yacremann/electron_event_generator/Board/Electron_generator/3D_files/conn_3.81mm.step

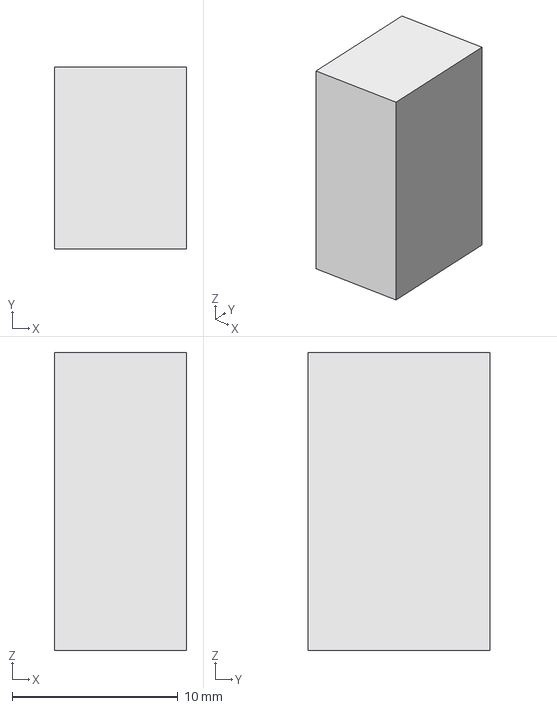
[picture p1: CAD file, 2022-10-03]
Board/Electron_generator/3D_files/conn_3.81mm.step
8.00 x 11.0 x 18.0 mm
