yacremann/electron_event_generator/Board/Electron_generator/Electron_generator.step

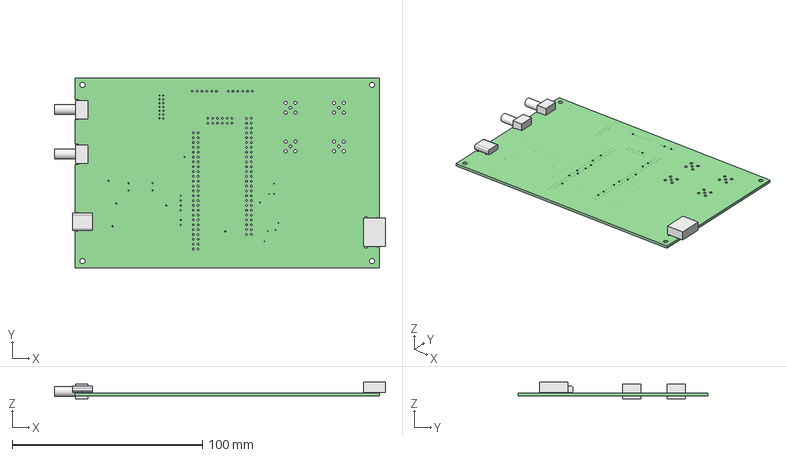
[picture p2: CAD file, 2022-10-03]
Board/Electron_generator/Electron_generator.step
173.8 x 100.0 x 8.90 mm
Electron_generator PCB
