yacremann/electron_event_generator/Board/Electron_generator/3D_files/HDMI_90.step

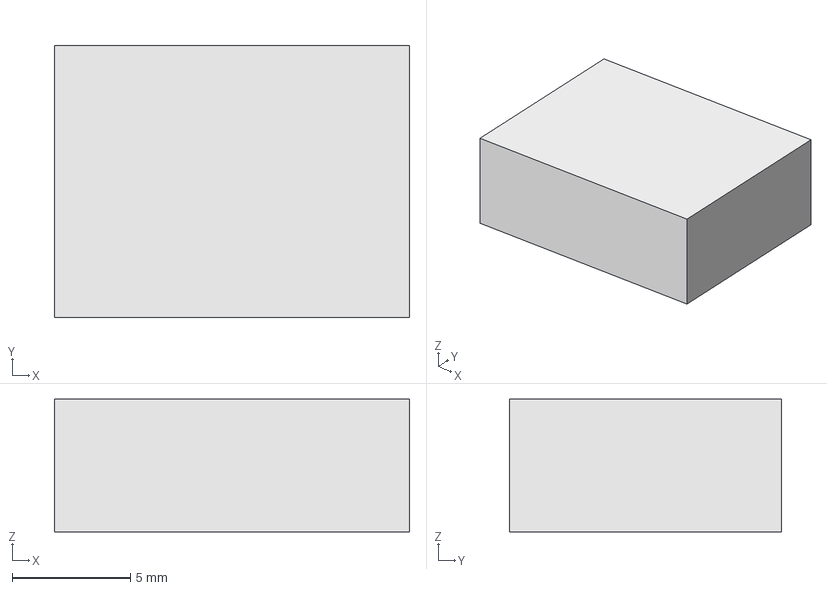
[picture p3: CAD file, 2022-10-03]
Board/Electron_generator/3D_files/HDMI_90.step
15.0 x 11.5 x 5.60 mm
