yacremann/electron_event_generator/Board/Electron_generator/3D_files/USB_C.step

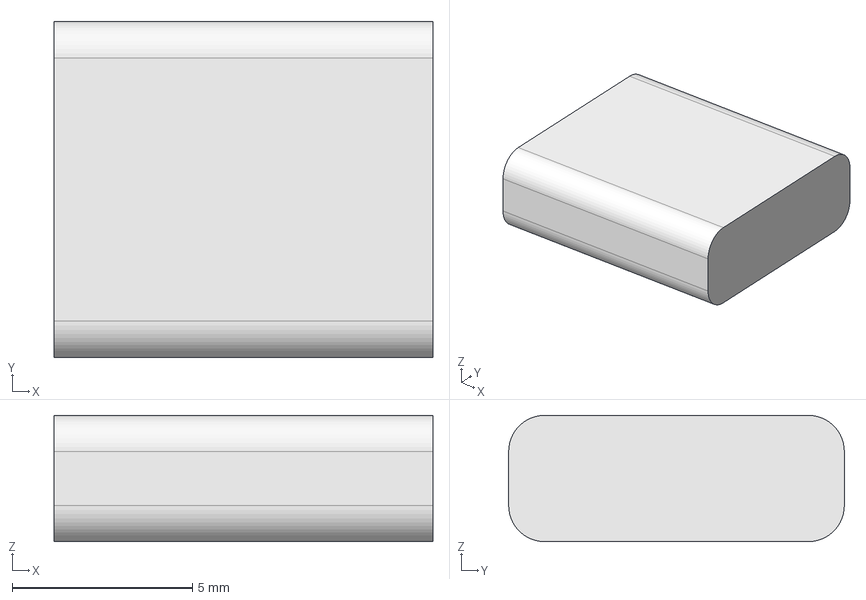
[picture p4: CAD file, 2022-10-03]
Board/Electron_generator/3D_files/USB_C.step
10.5 x 9.30 x 3.50 mm
