yacremann/electron_event_generator/Board/Electron_generator/3D_files/conn_sma.step

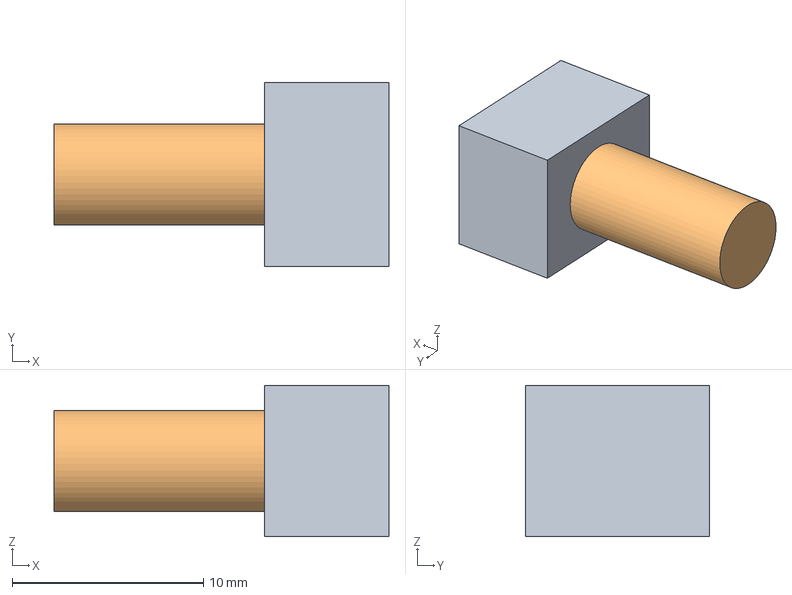
[picture p5: CAD file, 2022-10-03]
Board/Electron_generator/3D_files/conn_sma.step
17.5 x 9.60 x 7.90 mm
