yacremann/electron_event_generator/Board/Electron_generator/3D_files/RJ45.step

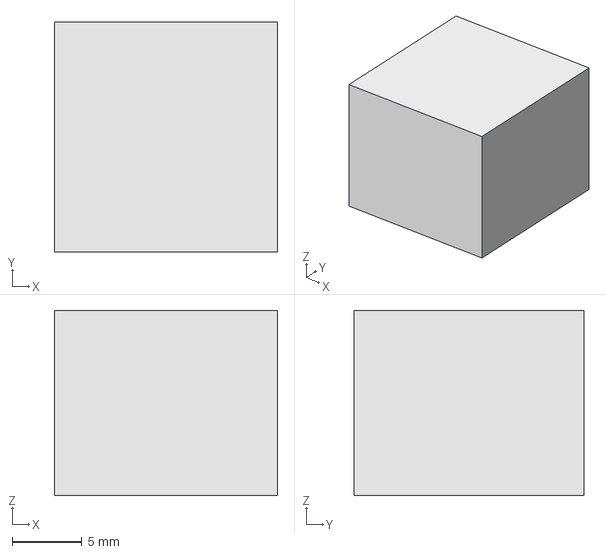
[picture p6: CAD file, 2022-10-03]
Board/Electron_generator/3D_files/RJ45.step
16.0 x 16.5 x 13.3 mm
