yacremann/electron_event_generator/(list of files, cad)

Other CAD files:
Board/Electron_generator/3D_files/HDMI_90.FCStd
Board/Electron_generator/3D_files/RJ45.FCStd
Board/Electron_generator/3D_files/USB_C.FCStd
Board/Electron_generator/3D_files/conn_3.81mm.FCStd
Board/Electron_generator/3D_files/conn_sma.FCStd
