yacremann/electron_event_generator/Board/Electron_generator/Schematic.pdf

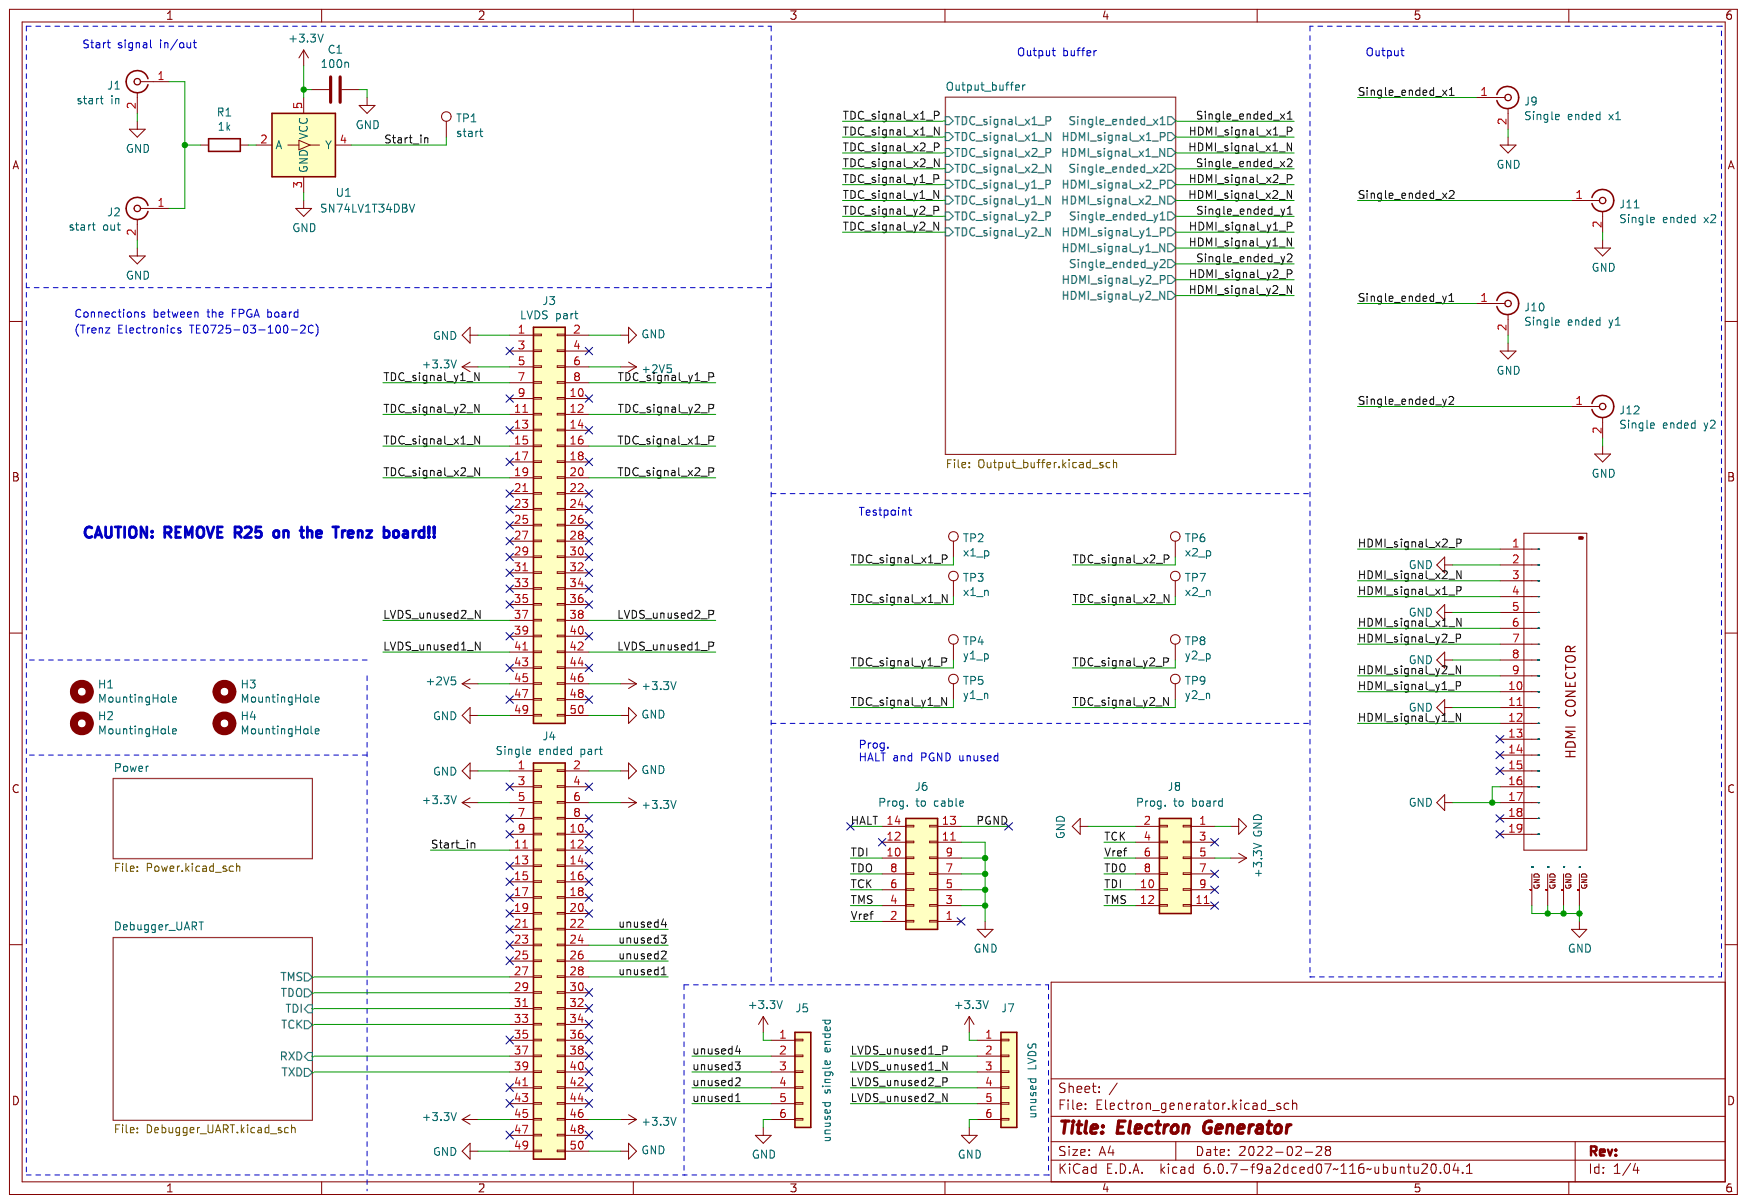
[picture p7: page 1]

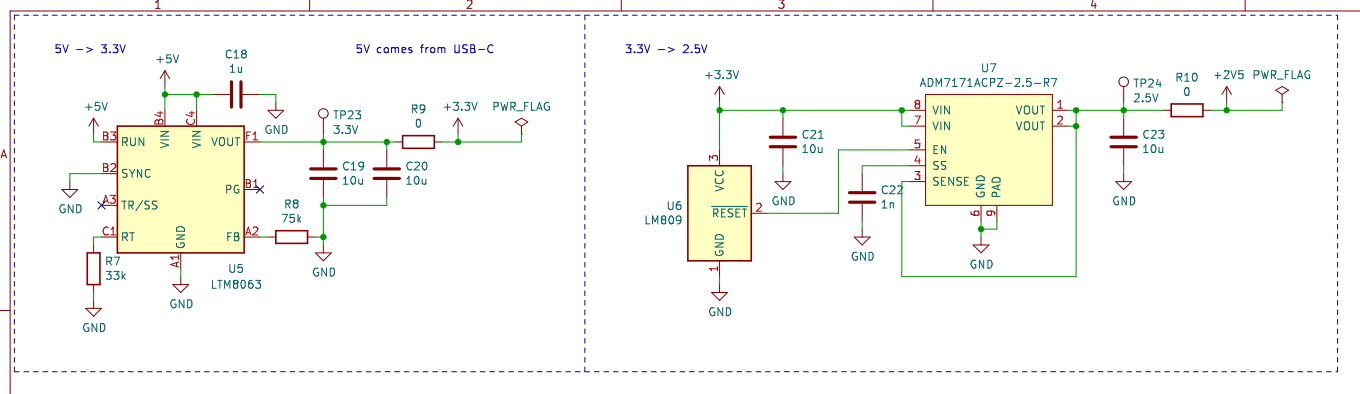
[picture p8: page 2]

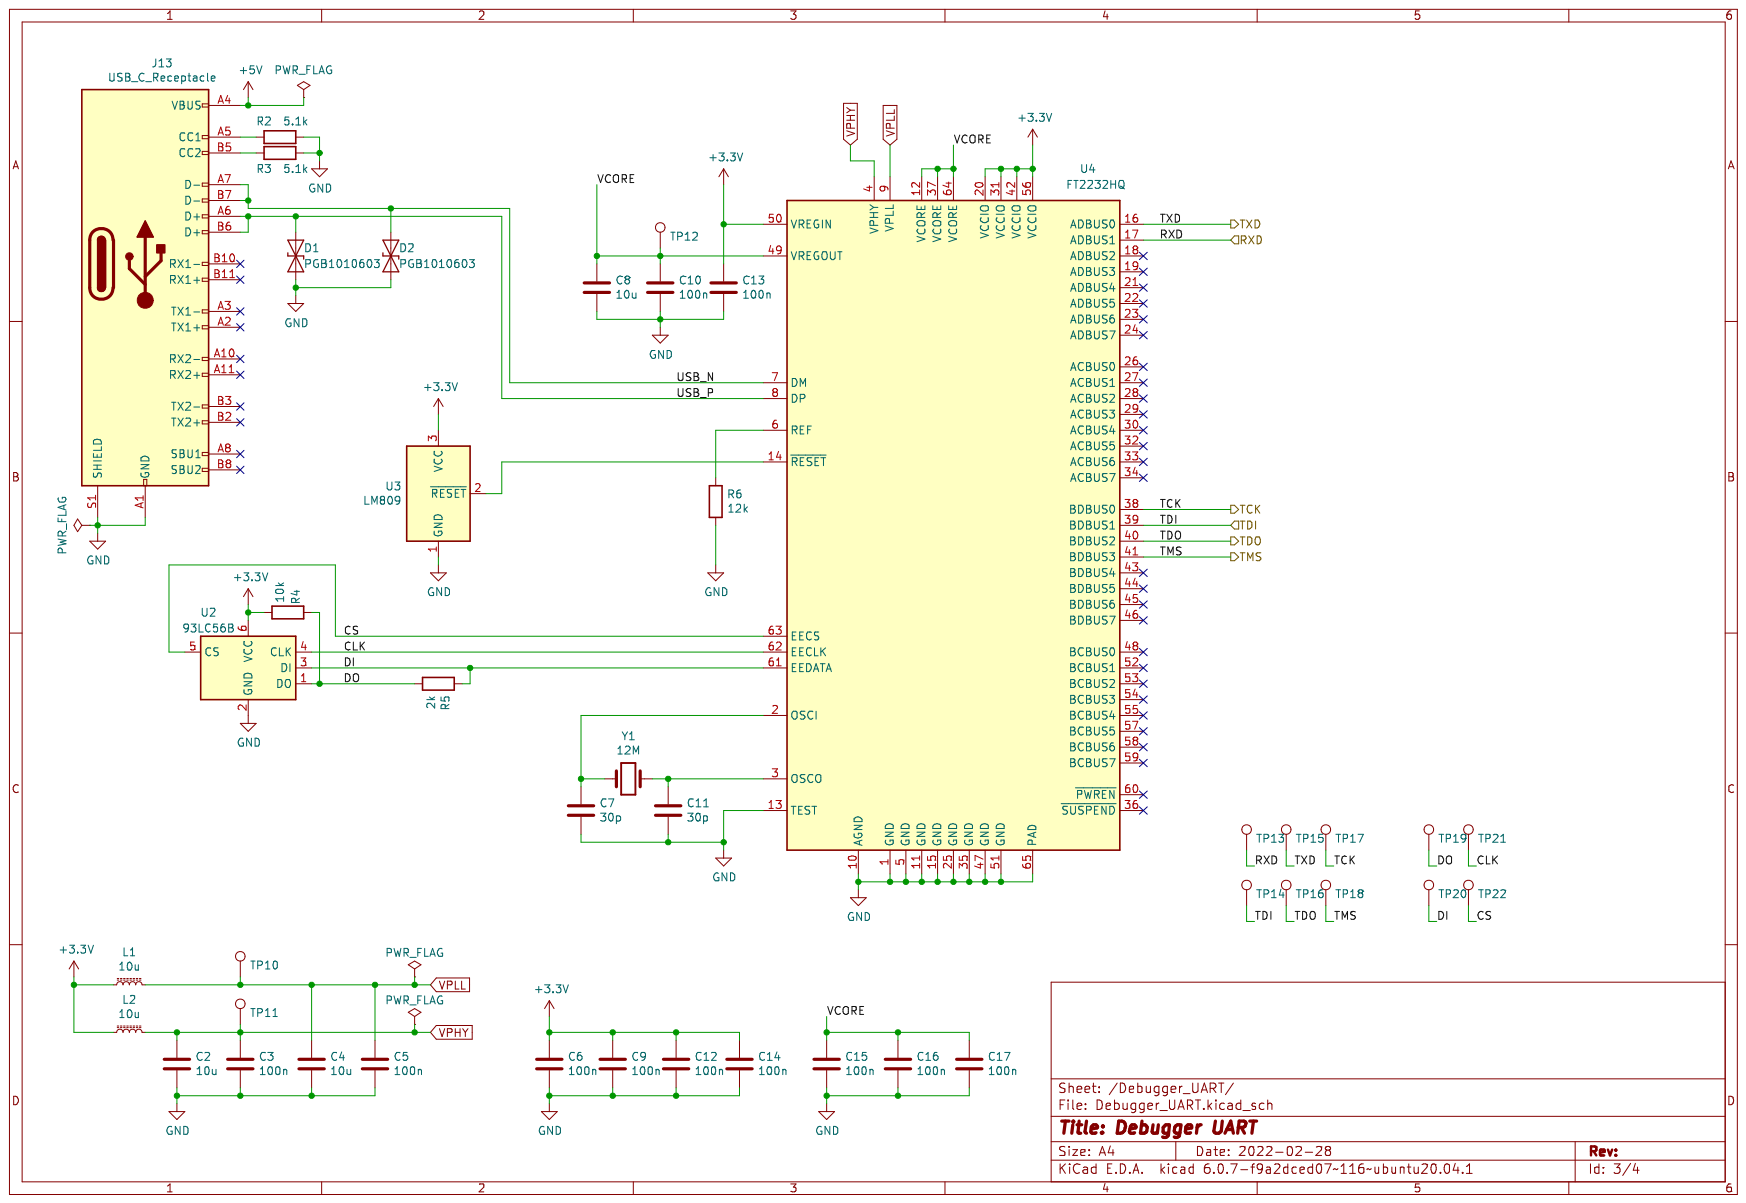
[picture p9: page 3]

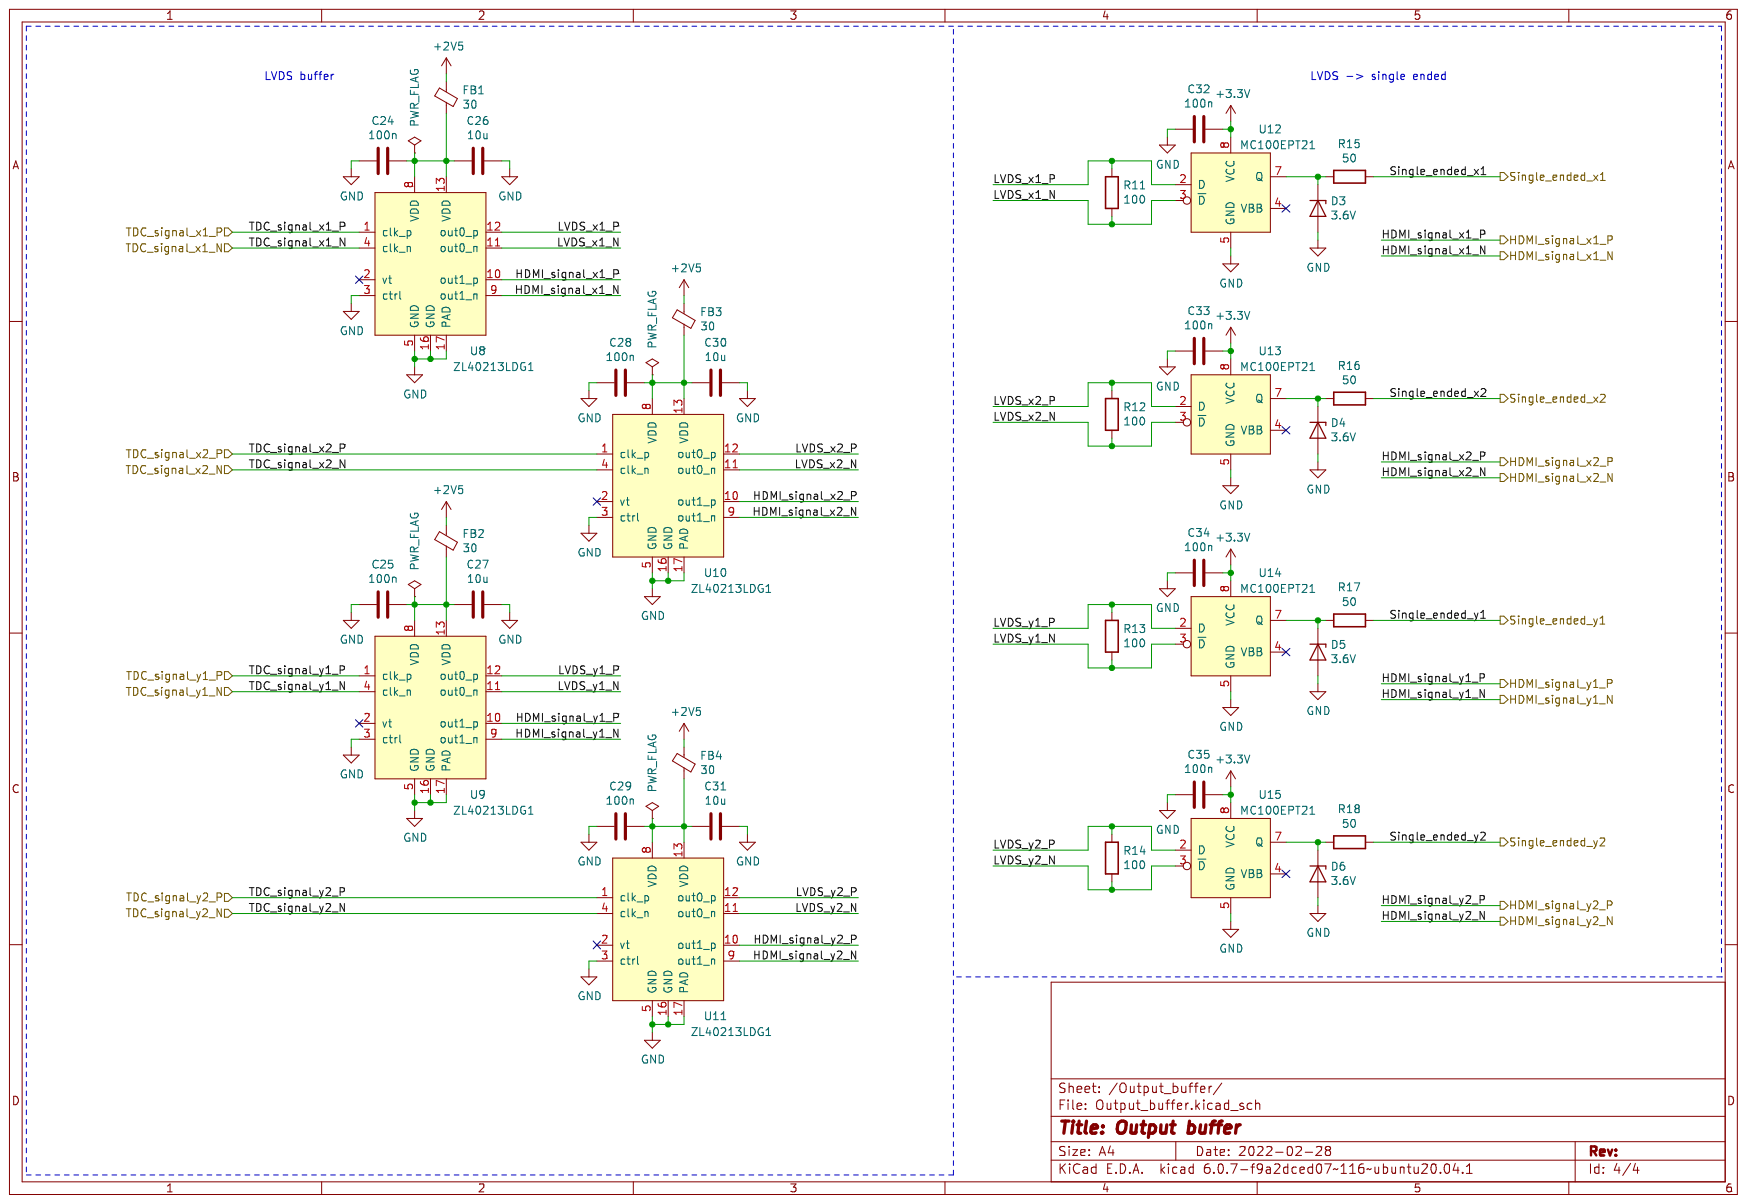
[picture p10: page 4]
