yacremann/electron_event_generator/Board/Electron_generator/Debugger_UART.kicad_sch

## KiCad design Board/Electron_generator/Debugger_UART.kicad_sch (2022-10-03)

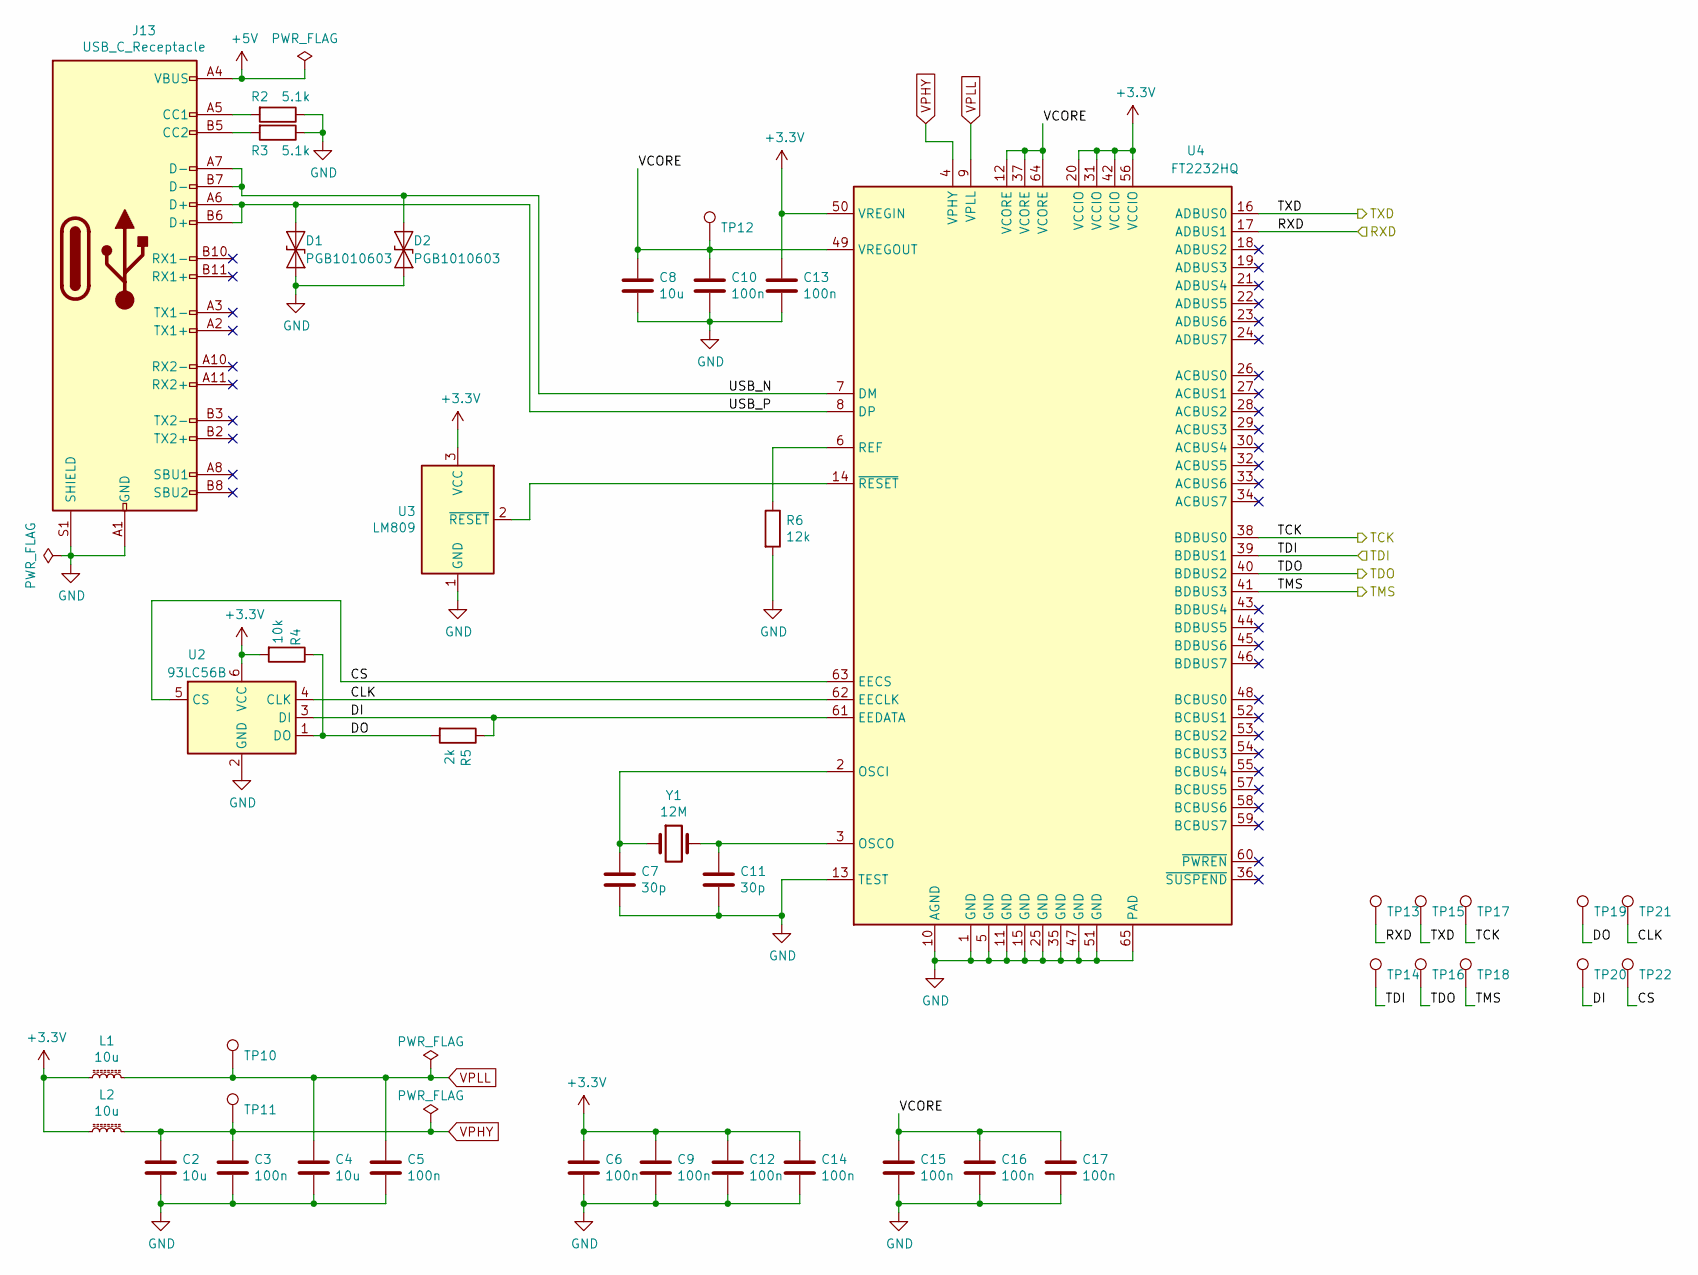
[picture p11: schematic Debugger_UART.kicad_sch]

Parts:
C2, C4, C8: 10u; C_0603_1608Metric
C3, C5, C6, C9, C10, C12, C13, C14, C15, C16, C17: 100n; C_0603_1608Metric
C7, C11: 30p; C_0603_1608Metric
D1, D2: PGB1010603; D_0603_1608Metric
J13: USB_C_Receptacle; USB_C_Receptacle_Amphenol_12401610E4-2A_CircularHoles
L1, L2: 10u; L_1008_2520Metric
R2, R3: 5.1k; R_0603_1608Metric
R4: 10k; R_0603_1608Metric
R5: 2k; R_0603_1608Metric
R6: 12k; R_0603_1608Metric
TP10, TP11, TP12, TP13, TP14, TP15, TP16, TP17, TP18, TP19, TP20, TP21, TP22: TestPoint; TestPoint_THTPad_D1.5mm_Drill0.7mm
U2: 93LC56B; SOT-23-6
U3: LM809; SOT-23
U4: FT2232HQ; QFN-64-1EP_9x9mm_P0.5mm_EP4.35x4.35mm
Y1: 12M; Crystal_SMD_5032-2Pin_5.0x3.2mm

Connections:
+3.3V: C6.1, C9.1, C12.1, C13.1, C14.1, L1.1, L2.1, R4.2, U2.6 (VCC), U3.3 (VCC), U4.20 (VCCIO), U4.31 (VCCIO), U4.42 (VCCIO), U4.50 (VREGIN), U4.56 (VCCIO)
+5V: J13.A4 (VBUS), J13.A9 (VBUS), J13.B4 (VBUS), J13.B9 (VBUS)
CLK: TP21.1, U2.4 (CLK), U4.62 (EECLK)
CS: TP22.1, U2.5 (CS), U4.63 (EECS)
DI: R5.1, TP20.1, U2.3 (DI), U4.61 (EEDATA)
DO: R4.1, R5.2, TP19.1, U2.1 (DO)
GND: C2.2, C3.2, C4.2, C5.2, C6.2, C7.2, C8.2, C9.2, C10.2, C11.2, C12.2, C13.2, C14.2, C15.2, C16.2, C17.2, D1.2 (A2), D2.2 (A2), J13.A1 (GND), J13.A12 (GND), J13.B1 (GND), J13.B12 (GND), J13.S1 (SHIELD), R2.1, R3.1, R6.2, U2.2 (GND), U3.1 (GND), U4.1 (GND), U4.5 (GND), U4.10 (AGND), U4.11 (GND), U4.13 (TEST), U4.15 (GND), U4.25 (GND), U4.35 (GND), U4.47 (GND), U4.51 (GND), U4.65 (PAD)
unnamed: C7.1, U4.2 (OSCI), Y1.1
unnamed: C11.1, U4.3 (OSCO), Y1.2
unnamed: J13.A5 (CC1), R2.2
unnamed: J13.B5 (CC2), R3.2
unnamed: R6.1, U4.6 (REF)
unnamed: U3.2 (~RESET), U4.14 (~RESET)
RXD: TP13.1, U4.17 (ADBUS1)
TCK: TP17.1, U4.38 (BDBUS0)
TDI: TP14.1, U4.39 (BDBUS1)
TDO: TP16.1, U4.40 (BDBUS2)
TMS: TP18.1, U4.41 (BDBUS3)
TXD: TP15.1, U4.16 (ADBUS0)
USB_N: D2.1 (A1), J13.A7 (D-), J13.B7 (D-), U4.7 (DM)
USB_P: D1.1 (A1), J13.A6 (D+), J13.B6 (D+), U4.8 (DP)
VCORE: C8.1, C10.1, C15.1, C16.1, C17.1, TP12.1, U4.12 (VCORE), U4.37 (VCORE), U4.49 (VREGOUT), U4.64 (VCORE)
VPHY: C2.1, C3.1, L2.2, TP11.1, U4.4 (VPHY)
VPLL: C4.1, C5.1, L1.2, TP10.1, U4.9 (VPLL)
