yacremann/electron_event_generator/Board/Electron_generator/Electron_generator.kicad_sch

## KiCad design Board/Electron_generator/Electron_generator.kicad_sch (2022-10-03)

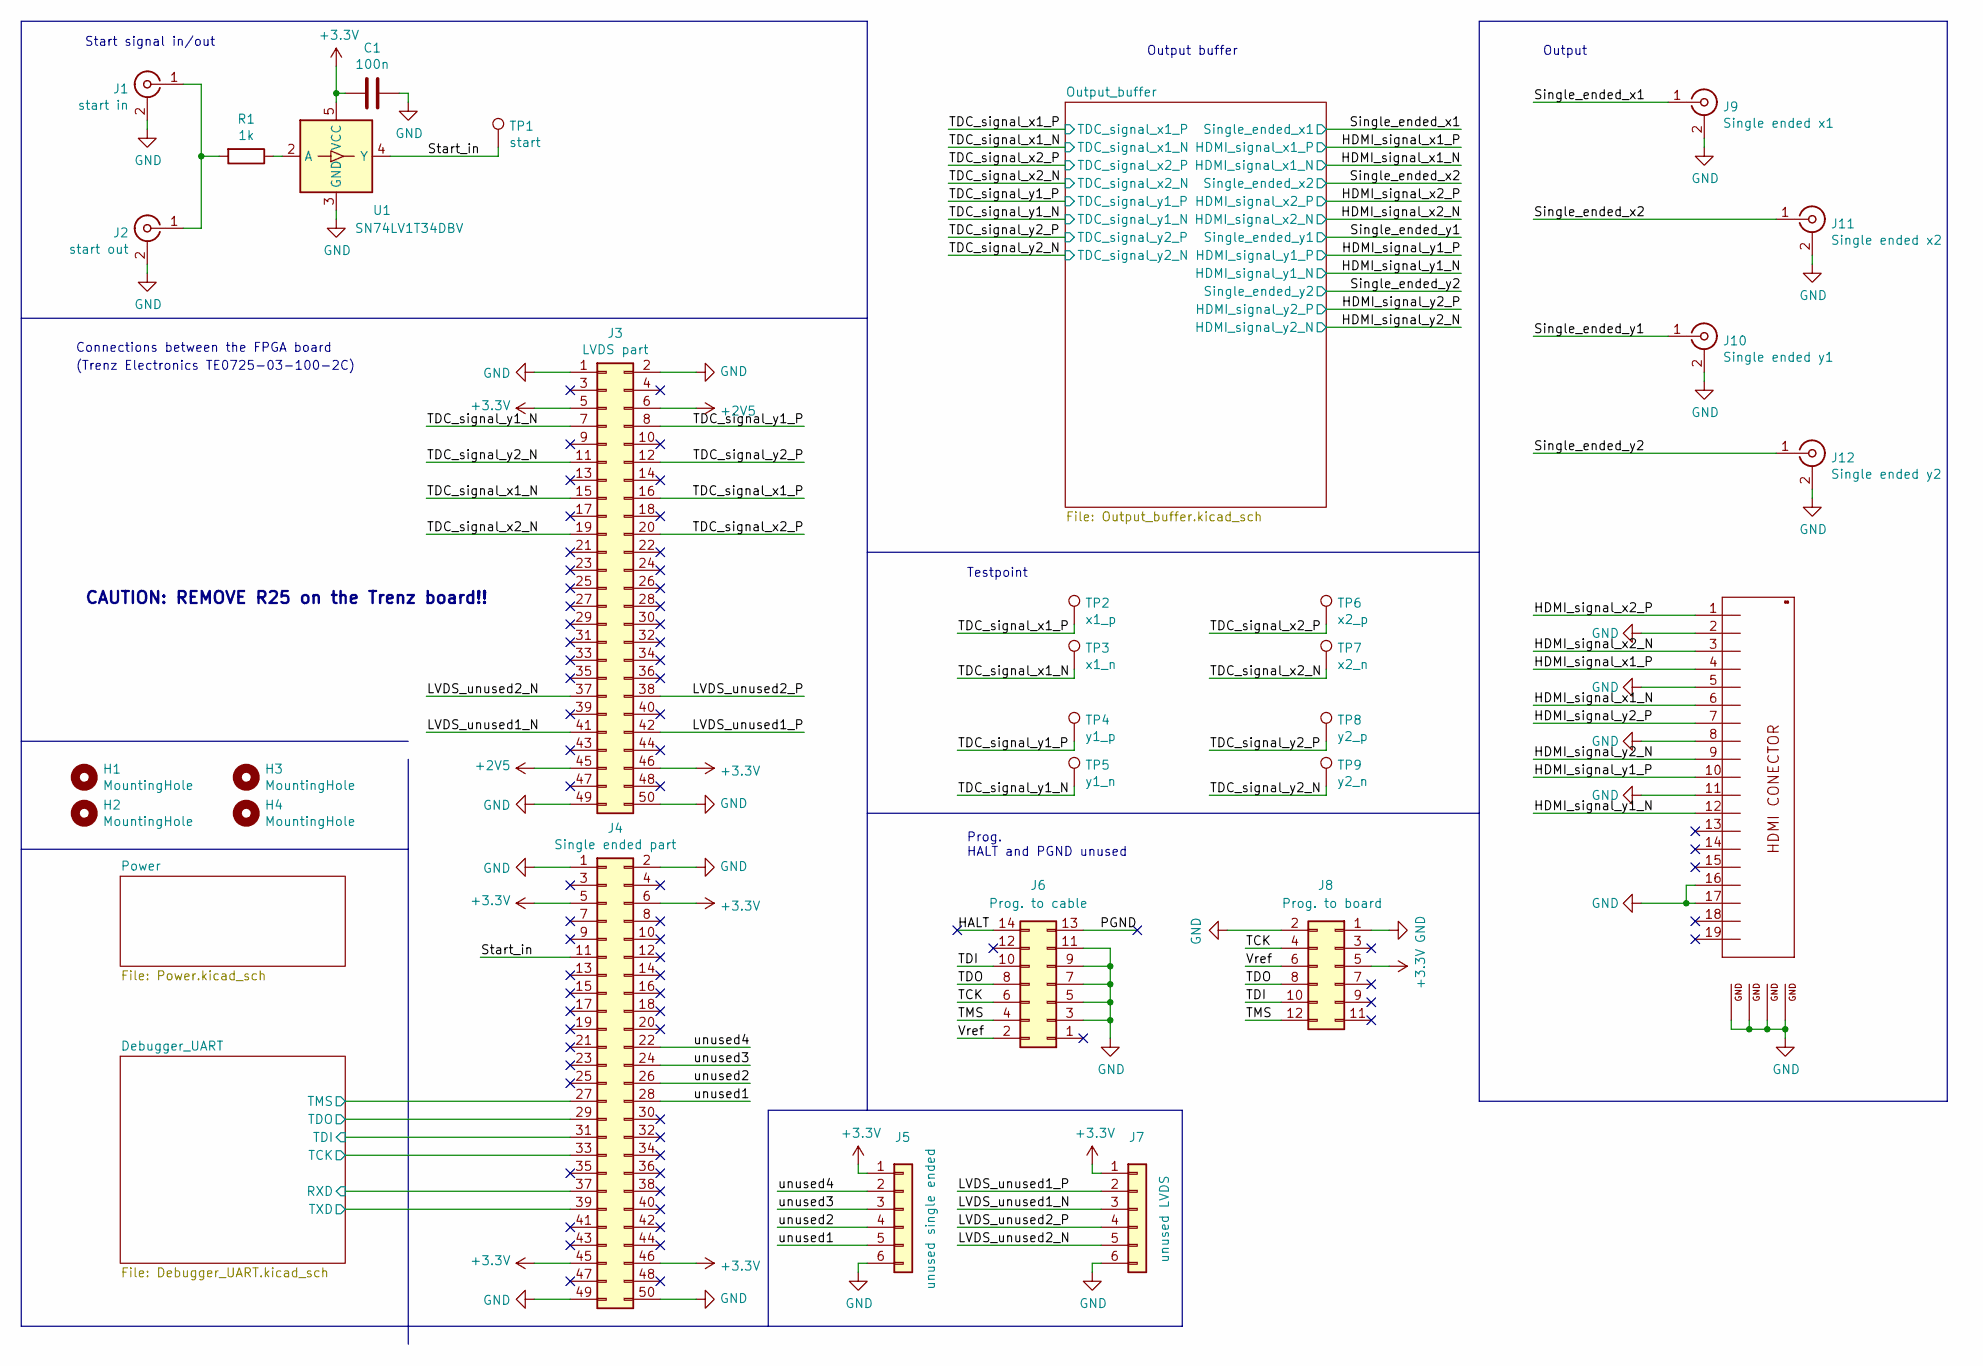
[picture p12: schematic Electron_generator.kicad_sch]

Parts:
C1: 100n; C_0603_1608Metric
H1, H2, H3, H4: MountingHole; MountingHole_2.7mm_M2.5
J1: start in; SMA_Amphenol_132289_EdgeMount
J2: start out; SMA_Amphenol_132289_EdgeMount
J3: LVDS part; PinSocket_2x25_P2.54mm_Vertical
J4: Single ended part; PinSocket_2x25_P2.54mm_Vertical
J5: unused single ended; PinSocket_1x06_P2.54mm_Vertical
J6: Prog. to cable; JST_PHD_B14B-PHDSS_2x07_P2.00mm_Vertical
J7: unused LVDS; PinSocket_1x06_P2.54mm_Vertical
J8: Prog. to board; PinSocket_2x06_P2.54mm_Vertical
J9: Single ended x1; SMA_Amphenol_901-144_Vertical
J10: Single ended y1; SMA_Amphenol_901-144_Vertical
J11: Single ended x2; SMA_Amphenol_901-144_Vertical
J12: Single ended y2; SMA_Amphenol_901-144_Vertical
R1: 1k; R_0603_1608Metric
ST1: HDMI_CONNECTOR90°; HDMI_90_SMD
TP1: start; TestPoint_THTPad_D1.5mm_Drill0.7mm
TP2: x1_p; TestPoint_THTPad_D1.0mm_Drill0.5mm
TP3: x1_n; TestPoint_THTPad_D1.0mm_Drill0.5mm
TP4: y1_p; TestPoint_THTPad_D1.0mm_Drill0.5mm
TP5: y1_n; TestPoint_THTPad_D1.0mm_Drill0.5mm
TP6: x2_p; TestPoint_THTPad_D1.0mm_Drill0.5mm
TP7: x2_n; TestPoint_THTPad_D1.0mm_Drill0.5mm
TP8: y2_p; TestPoint_THTPad_D1.0mm_Drill0.5mm
TP9: y2_n; TestPoint_THTPad_D1.0mm_Drill0.5mm
U1: SN74LV1T34DBV; SOT-23-5

Connections:
+2V5: J3.6, J3.45
+3.3V: C1.2, J3.5, J3.46, J4.5, J4.6, J4.45, J4.46, J5.1, J7.1, J8.5, U1.5 (VCC)
GND: C1.1, J1.2 (Ext), J2.2 (Ext), J3.1, J3.2, J3.49, J3.50, J4.1, J4.2, J4.49, J4.50, J5.6, J6.3, J6.5, J6.7, J6.9, J6.11, J7.6, J8.1, J8.2, J9.2 (Ext), J10.2 (Ext), J11.2 (Ext), J12.2 (Ext), ST1.2, ST1.5, ST1.8, ST1.11, ST1.16, ST1.17, ST1.P$1 (GND), ST1.P$2 (GND), ST1.P$3 (GND), ST1.P$4 (GND), U1.3 (GND)
HALT: J6.14
HDMI_signal_x1_N: ST1.6
HDMI_signal_x1_P: ST1.4
HDMI_signal_x2_N: ST1.3
HDMI_signal_x2_P: ST1.1
HDMI_signal_y1_N: ST1.12
HDMI_signal_y1_P: ST1.10
HDMI_signal_y2_N: ST1.9
HDMI_signal_y2_P: ST1.7
LVDS_unused1_N: J3.41, J7.3
LVDS_unused1_P: J3.42, J7.2
LVDS_unused2_N: J3.37, J7.5
LVDS_unused2_P: J3.38, J7.4
unnamed: J1.1 (In), J2.1 (In), R1.2
unnamed: R1.1, U1.2 (A)
PGND: J6.13
RXD: J4.37
Single_ended_x1: J9.1 (In)
Single_ended_x2: J11.1 (In)
Single_ended_y1: J10.1 (In)
Single_ended_y2: J12.1 (In)
Start_in: J4.11, TP1.1, U1.4 (Y)
TCK: J4.33, J6.6, J8.4
TDC_signal_x1_N: J3.15, TP3.1
TDC_signal_x1_P: J3.16, TP2.1
TDC_signal_x2_N: J3.19, TP7.1
TDC_signal_x2_P: J3.20, TP6.1
TDC_signal_y1_N: J3.7, TP5.1
TDC_signal_y1_P: J3.8, TP4.1
TDC_signal_y2_N: J3.11, TP9.1
TDC_signal_y2_P: J3.12, TP8.1
TDI: J4.31, J6.10, J8.10
TDO: J4.29, J6.8, J8.8
TMS: J4.27, J6.4, J8.12
TXD: J4.39
Vref: J6.2, J8.6
unused1: J4.28, J5.5
unused2: J4.26, J5.4
unused3: J4.24, J5.3
unused4: J4.22, J5.2

Notes on the sheet:
Prog. HALT and PGND unused
Output
Output buffer
CAUTION: REMOVE R25 on the Trenz board!!
Testpoint
Connections between the FPGA board
(Trenz Electronics TE0725-03-100-2C)
Start signal in/out
