yacremann/electron_event_generator/Board/Electron_generator/Output_buffer.kicad_sch

## KiCad design Board/Electron_generator/Output_buffer.kicad_sch (2022-10-03)

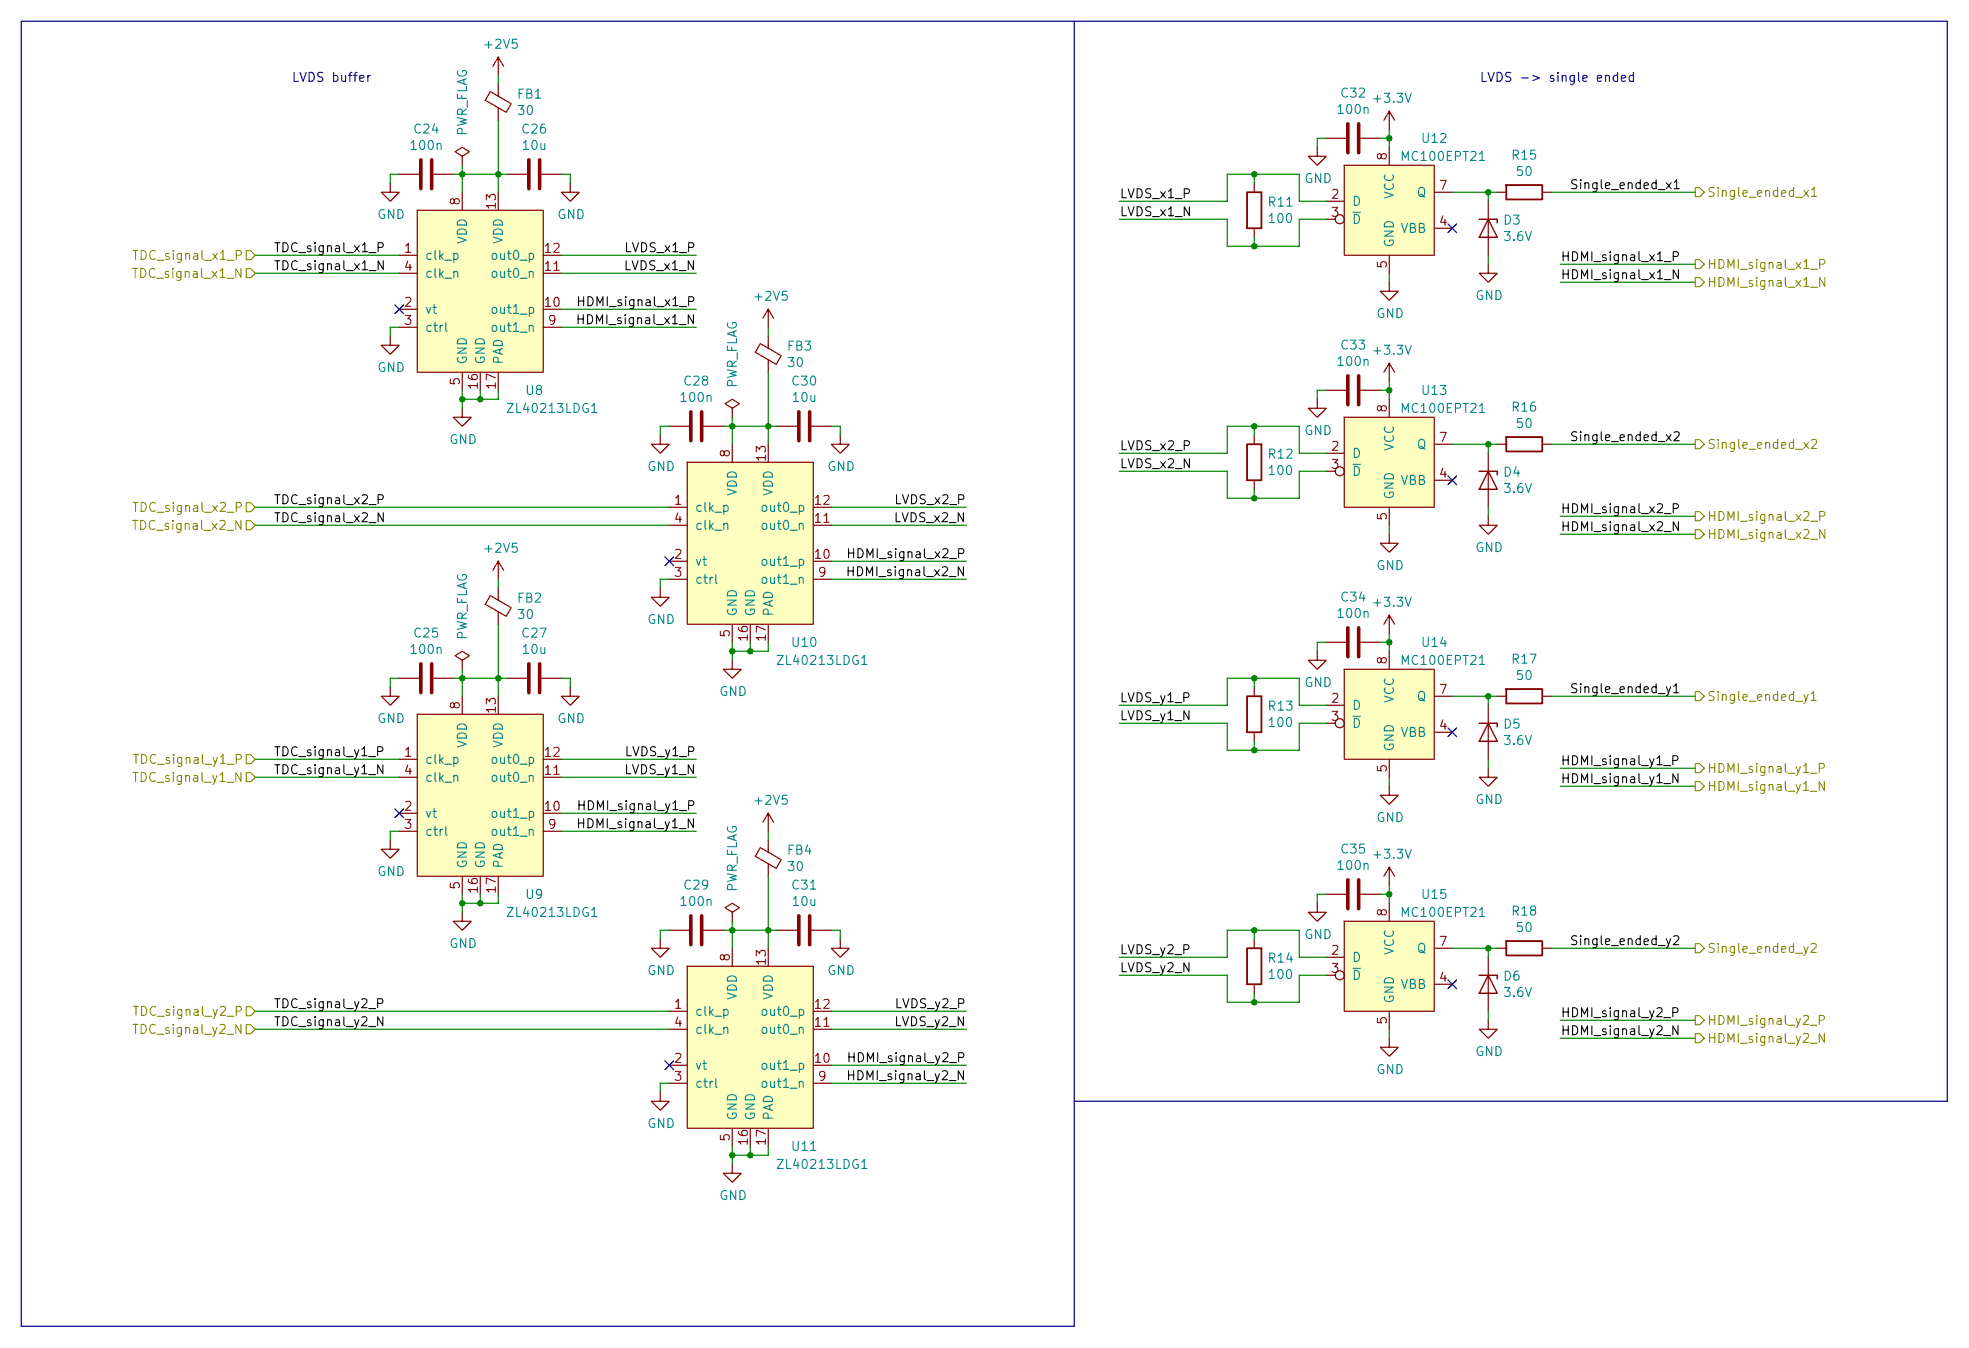
[picture p13: schematic Output_buffer.kicad_sch]

Parts:
C24, C25, C28, C29, C32, C33, C34, C35: 100n; C_0603_1608Metric
C26, C27, C30, C31: 10u; C_0603_1608Metric
D3, D4, D5, D6: 3.6V; D_0805_2012Metric
FB1, FB2, FB3, FB4: 30; L_0402_1005Metric
R11, R12, R13, R14: 100; R_0603_1608Metric
R15, R16, R17, R18: 50; R_0603_1608Metric
U8, U9, U10, U11: ZL40213LDG1; QFN-16-1EP_3x3mm_P0.5mm_EP1.45x1.45mm
U12, U13, U14, U15: MC100EPT21; TSSOP-8_3x3mm_P0.65mm

Connections:
+2V5: FB1.1, FB2.1, FB3.1, FB4.1
+3.3V: C32.1, C33.1, C34.1, C35.1, U12.8 (VCC), U13.8 (VCC), U14.8 (VCC), U15.8 (VCC)
GND: C24.2, C25.2, C26.1, C27.1, C28.2, C29.2, C30.1, C31.1, C32.2, C33.2, C34.2, C35.2, D3.2 (A), D4.2 (A), D5.2 (A), D6.2 (A), U8.3 (ctrl), U8.5 (GND), U8.16 (GND), U8.17 (PAD), U9.3 (ctrl), U9.5 (GND), U9.16 (GND), U9.17 (PAD), U10.3 (ctrl), U10.5 (GND), U10.16 (GND), U10.17 (PAD), U11.3 (ctrl), U11.5 (GND), U11.16 (GND), U11.17 (PAD), U12.5 (GND), U13.5 (GND), U14.5 (GND), U15.5 (GND)
HDMI_signal_x1_N: U8.9 (out1_n)
HDMI_signal_x1_P: U8.10 (out1_p)
HDMI_signal_x2_N: U10.9 (out1_n)
HDMI_signal_x2_P: U10.10 (out1_p)
HDMI_signal_y1_N: U9.9 (out1_n)
HDMI_signal_y1_P: U9.10 (out1_p)
HDMI_signal_y2_N: U11.9 (out1_n)
HDMI_signal_y2_P: U11.10 (out1_p)
LVDS_x1_N: R11.2, U8.11 (out0_n), U12.3 (~D)
LVDS_x1_P: R11.1, U8.12 (out0_p), U12.2 (D)
LVDS_x2_N: R12.2, U10.11 (out0_n), U13.3 (~D)
LVDS_x2_P: R12.1, U10.12 (out0_p), U13.2 (D)
LVDS_y1_N: R13.2, U9.11 (out0_n), U14.3 (~D)
LVDS_y1_P: R13.1, U9.12 (out0_p), U14.2 (D)
LVDS_y2_N: R14.2, U11.11 (out0_n), U15.3 (~D)
LVDS_y2_P: R14.1, U11.12 (out0_p), U15.2 (D)
unnamed: C24.1, C26.2, FB1.2, U8.8 (VDD), U8.13 (VDD)
unnamed: C25.1, C27.2, FB2.2, U9.8 (VDD), U9.13 (VDD)
unnamed: C28.1, C30.2, FB3.2, U10.8 (VDD), U10.13 (VDD)
unnamed: C29.1, C31.2, FB4.2, U11.8 (VDD), U11.13 (VDD)
unnamed: D3.1 (K), R15.2, U12.7 (Q)
unnamed: D4.1 (K), R16.2, U13.7 (Q)
unnamed: D5.1 (K), R17.2, U14.7 (Q)
unnamed: D6.1 (K), R18.2, U15.7 (Q)
Single_ended_x1: R15.1
Single_ended_x2: R16.1
Single_ended_y1: R17.1
Single_ended_y2: R18.1
TDC_signal_x1_N: U8.4 (clk_n)
TDC_signal_x1_P: U8.1 (clk_p)
TDC_signal_x2_N: U10.4 (clk_n)
TDC_signal_x2_P: U10.1 (clk_p)
TDC_signal_y1_N: U9.4 (clk_n)
TDC_signal_y1_P: U9.1 (clk_p)
TDC_signal_y2_N: U11.4 (clk_n)
TDC_signal_y2_P: U11.1 (clk_p)

Notes on the sheet:
LVDS -> single ended
LVDS buffer
