yacremann/electron_event_generator/Board/Electron_generator/Power.kicad_sch

## KiCad design Board/Electron_generator/Power.kicad_sch (2022-10-03)

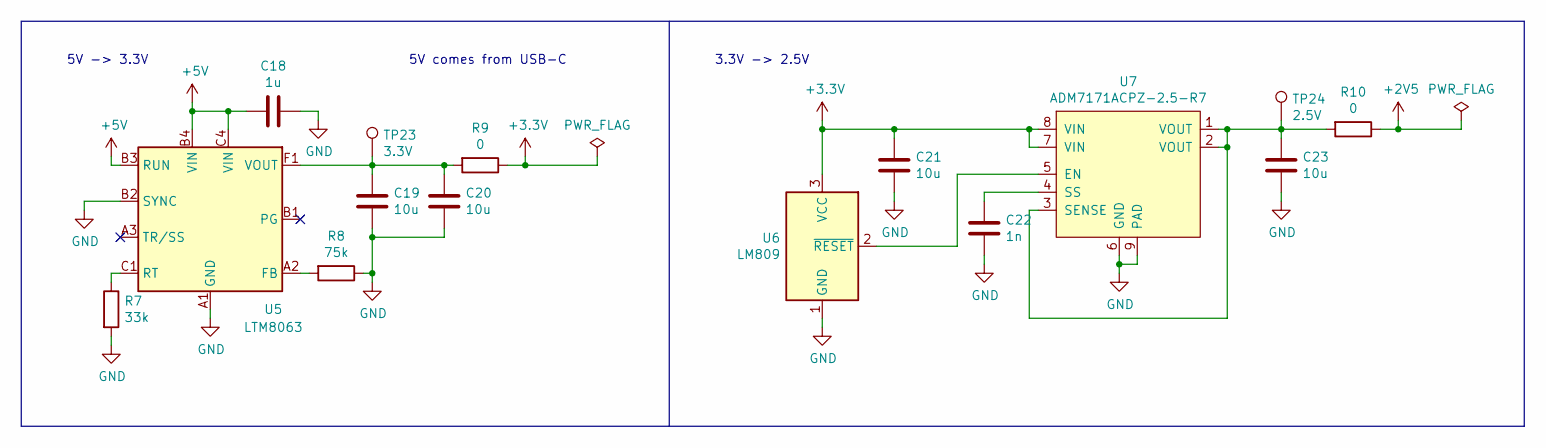
[picture p14: schematic Power.kicad_sch]

Parts:
C18: 1u; C_0603_1608Metric
C19, C20, C21, C23: 10u; C_0603_1608Metric
C22: 1n; C_0603_1608Metric
R7: 33k; R_0603_1608Metric
R8: 75k; R_0603_1608Metric
R9: 0; R_1206_3216Metric
R10: 0; R_0603_1608Metric
TP23: 3.3V; TestPoint_THTPad_D1.5mm_Drill0.7mm
TP24: 2.5V; TestPoint_THTPad_D1.5mm_Drill0.7mm
U5: LTM8063; Analog_BGA-28_4.0x6.25mm_Layout4x7_P0.8mm_Ball0.45mm_Pad0.4
U6: LM809; SOT-23
U7: ADM7171ACPZ-2.5-R7; LFCSP-8-1EP_3x3mm_P0.5mm_EP1.45x1.74mm

Connections:
+2V5: R10.1
+3.3V: C21.1, R9.1, U6.3 (VCC), U7.7 (VIN), U7.8 (VIN)
+5V: C18.2, U5.B3 (RUN), U5.B4 (VIN), U5.C4 (VIN)
GND: C18.1, C19.2, C20.2, C21.2, C22.2, C23.2, R7.2, R8.1, U5.A1 (GND), U5.A4 (GND), U5.B2 (SYNC), U5.C2 (GND), U5.C3 (GND), U5.D1 (GND), U5.D2 (GND), U5.D3 (GND), U5.D4 (GND), U5.E1 (GND), U5.E2 (GND), U5.E3 (GND), U5.E4 (GND), U6.1 (GND), U7.6 (GND), U7.9 (PAD)
unnamed: C19.1, C20.1, R9.2, TP23.1, U5.F1 (VOUT), U5.F2 (VOUT), U5.F3 (VOUT), U5.F4 (VOUT), U5.G1 (VOUT), U5.G2 (VOUT), U5.G3 (VOUT), U5.G4 (VOUT)
unnamed: C22.1, U7.4 (SS)
unnamed: C23.1, R10.2, TP24.1, U7.1 (VOUT), U7.2 (VOUT), U7.3 (SENSE)
unnamed: R7.1, U5.C1 (RT)
unnamed: R8.2, U5.A2 (FB)
unnamed: U6.2 (~RESET), U7.5 (EN)

Notes on the sheet:
3.3V -> 2.5V
5V -> 3.3V
5V comes from USB-C
